eagletrt/hw-fenice-ecu/README.md

# ECU - hardware

ECU hardware design of the E-Agle Trento Racing Team car which run on Fenice.

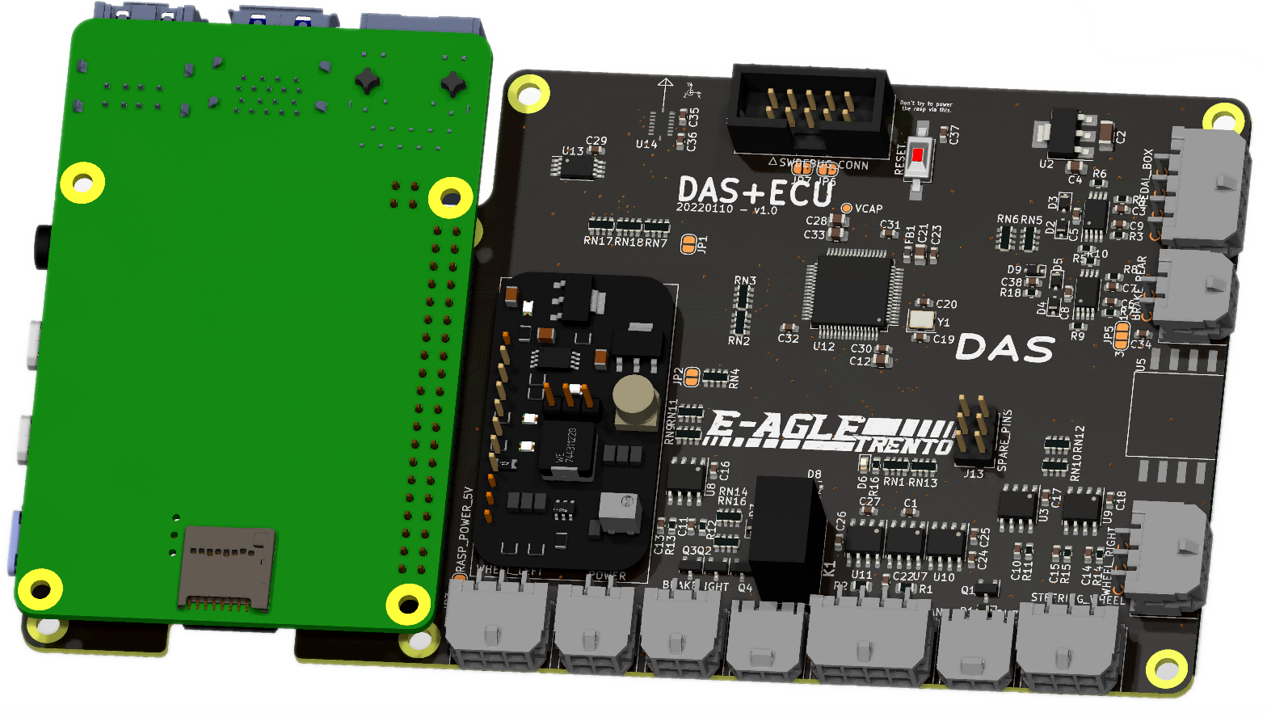
[picture p1: docs/images/board_render.png]


## Contributors

- Filippo Volpe

## Documentation

Documentation can be found under [`./docs/DAS_ECU.md`](./docs/DAS_ECU.md)
