eagletrt/hw-fenice-ecu/docs/board_outline.dxf

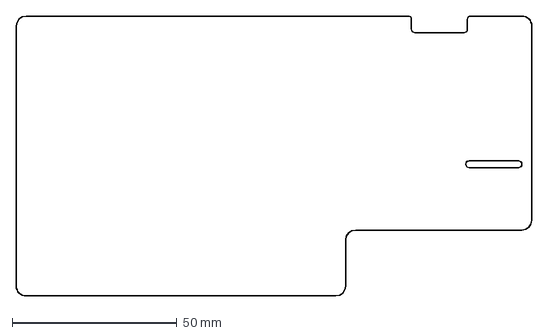
[picture p8: CAD file, 2022-01-07]
docs/board_outline.dxf
156.5 x 85.0 mm
