eagletrt/hw-fenice-ecu/docs/DAS_ECU.pdf

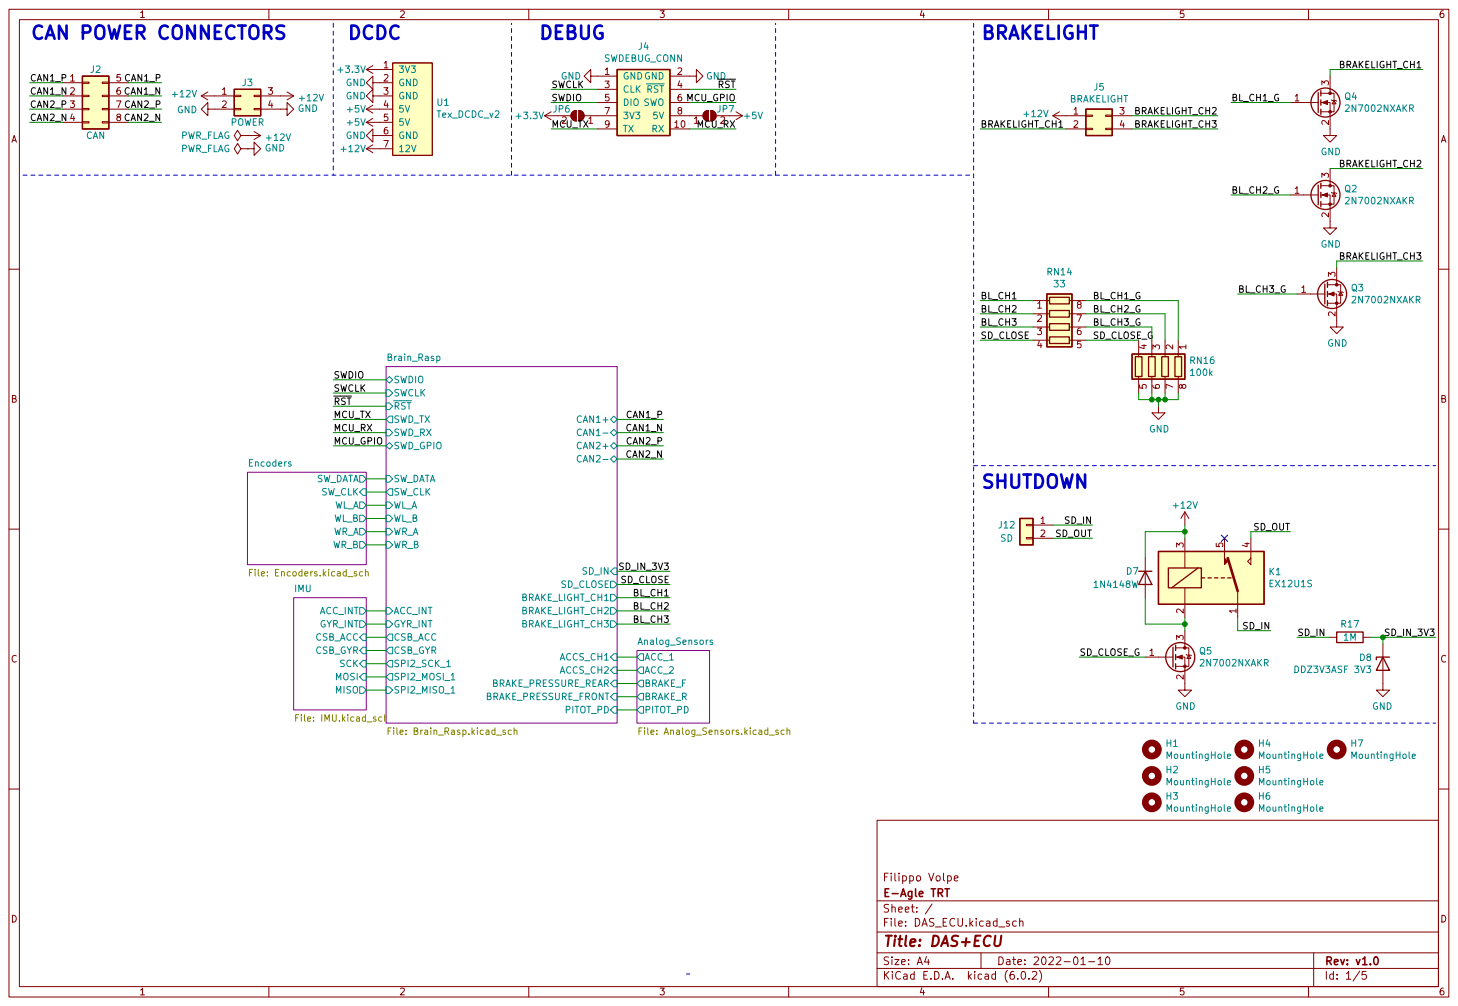
[picture p9: page 1]

CSB_GYR
File: Analog_Sensors.kicad_sch SCK MOSI MISO

File: DAS_ECU.kicad_sch Sheet: / E-Agle TRT

Id: 1/5 Title: DAS+ECU

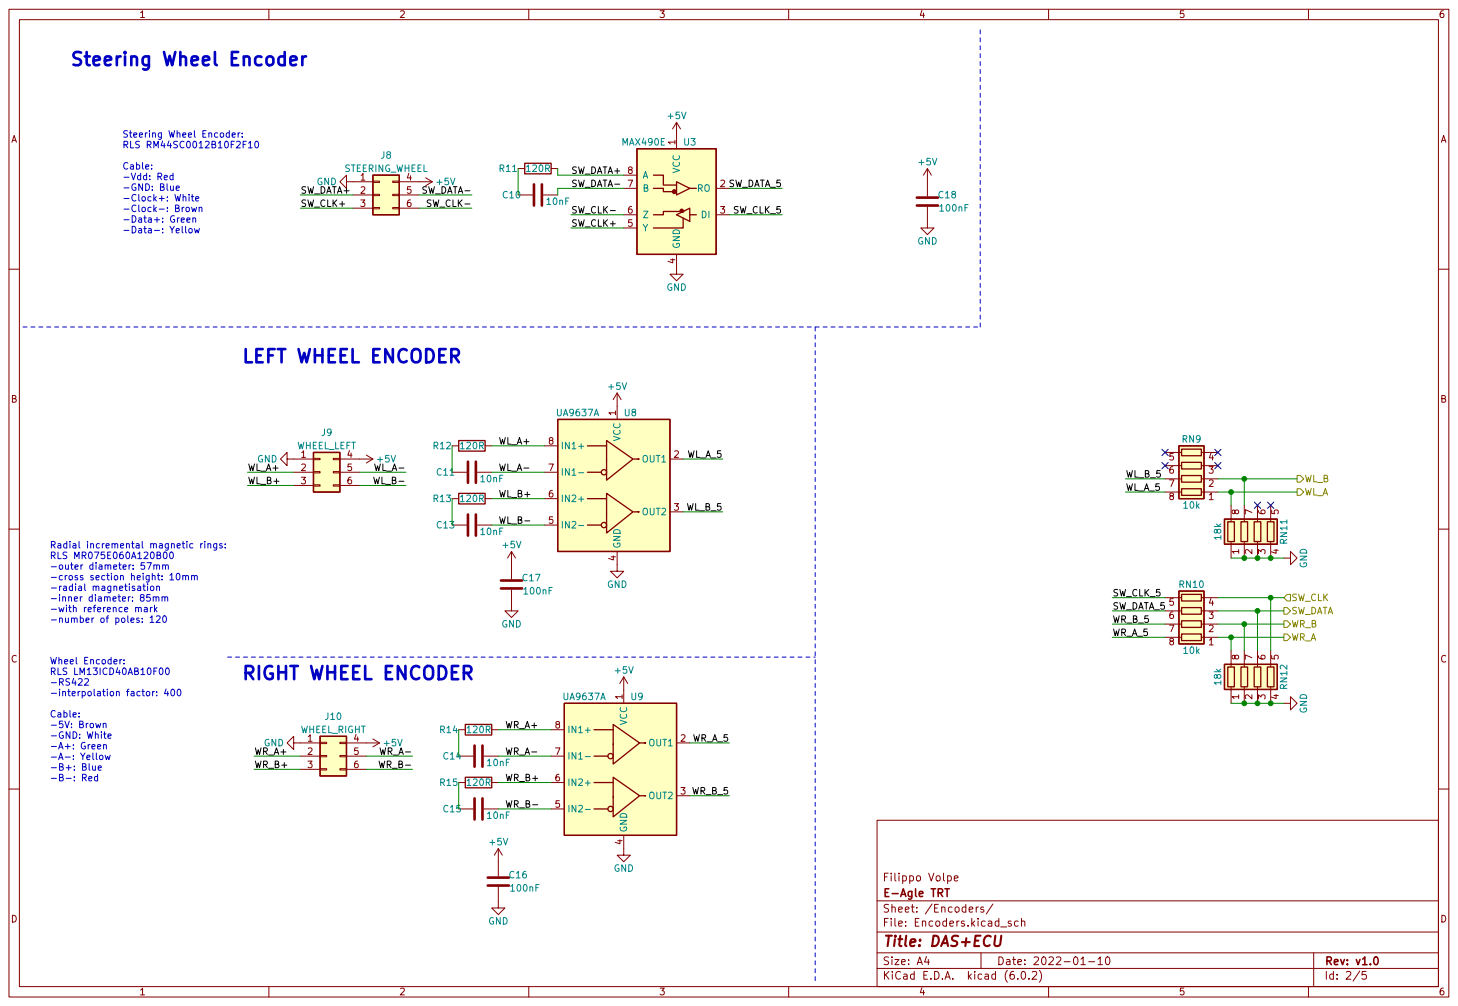
[picture p10: page 2]

Steering Wheel Encoder: RLS RM44SC0012B10F2F10 Cable: -Vdd: Red

Radial incremental magnetic rings: RLS MR075E060A120B00

-interpolation factor: 400 Cable: -5V: Brown

Filippo Volpe
File: Encoders.kicad_sch Sheet: /Encoders/ E-Agle TRT

Id: 2/5 Title: DAS+ECU

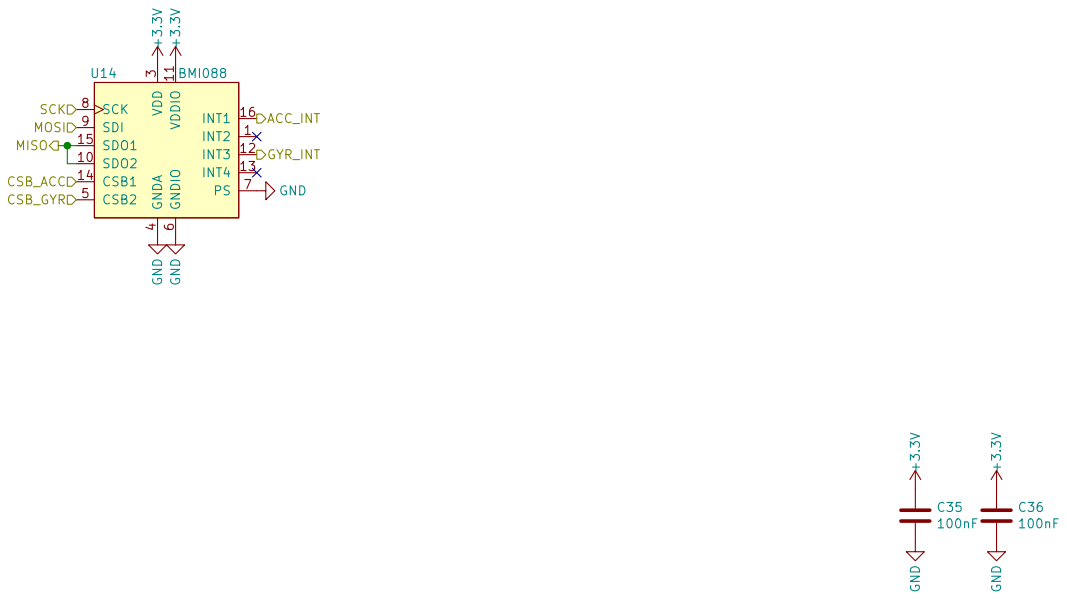
[picture p11: page 3]

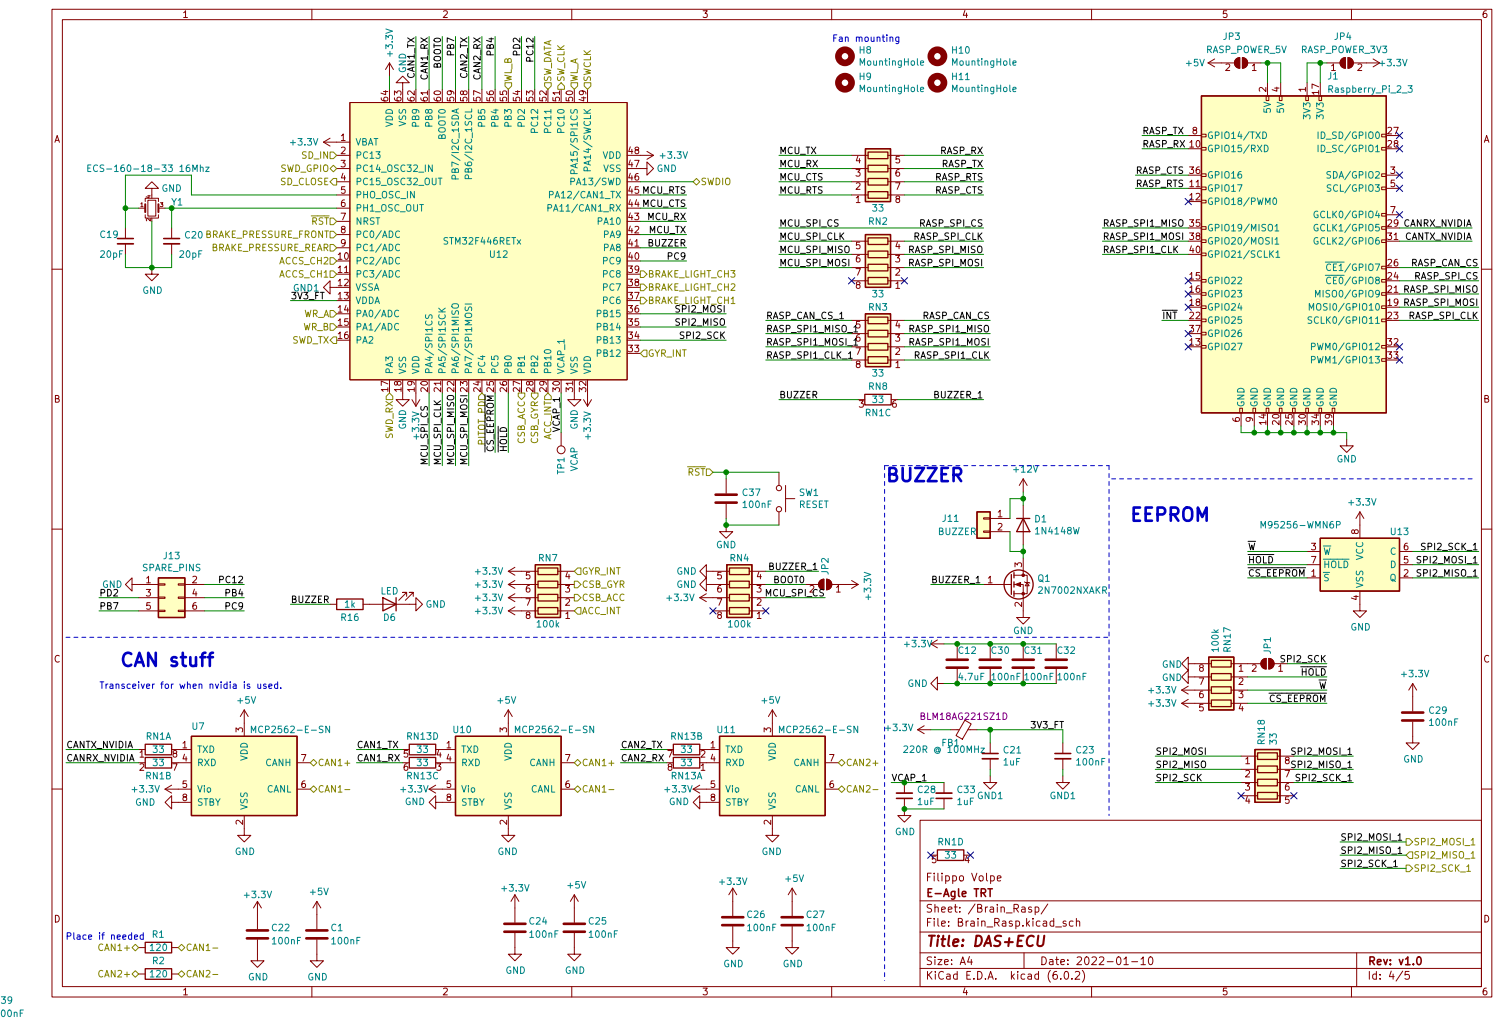
[picture p12: page 4]

3 RXD 4 Vio 5 CANL 6 CANH 7 STBY 8 U10 MCP2562-E-SN GND1

J13 SPARE_PINS GND
Place if needed CAN stuff

Transceiver for when nvidia is used.

3 RXD 4 Vio 5 CANL 6 CANH 7 STBY 8 U7 MCP2562-E-SN GND

3 RXD 4 Vio 5 CANL 6 CANH 7 STBY 8 U11 MCP2562-E-SN

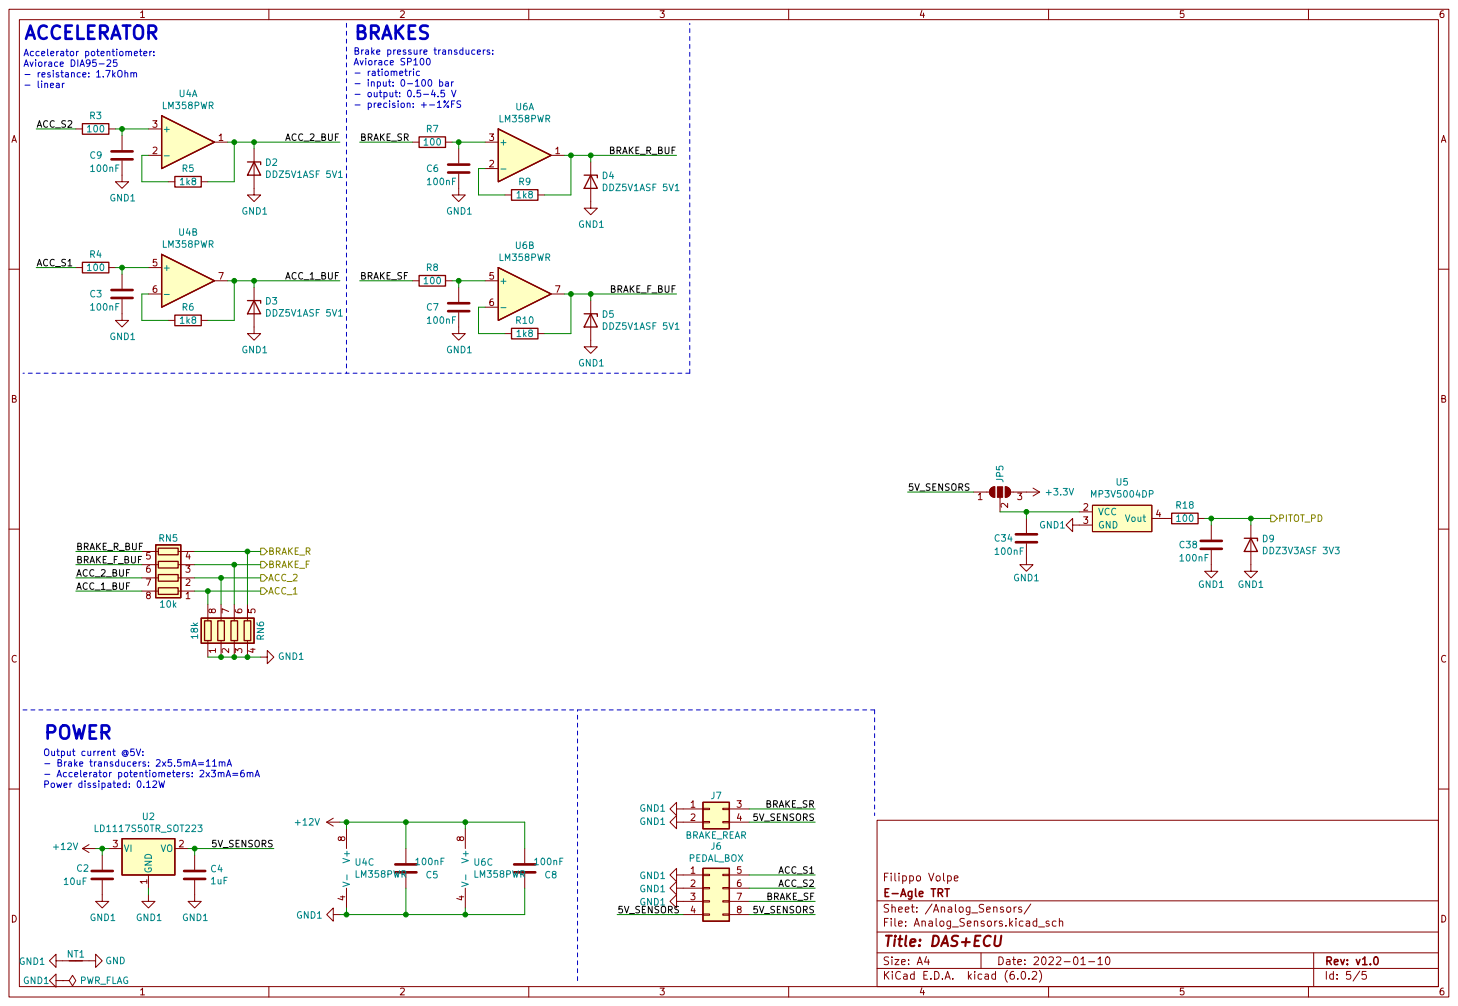
[picture p13: page 5]

Filippo Volpe
E-Agle TRT
Sheet: /Analog_Sensors/
File: Analog_Sensors.kicad_sch
Id: 5/5 Title: DAS+ECU
