eagletrt/hw-fenice-ecu/DAS_ECU.kicad_pcb

## KiCad design DAS_ECU.kicad_pcb (2022-03-17)

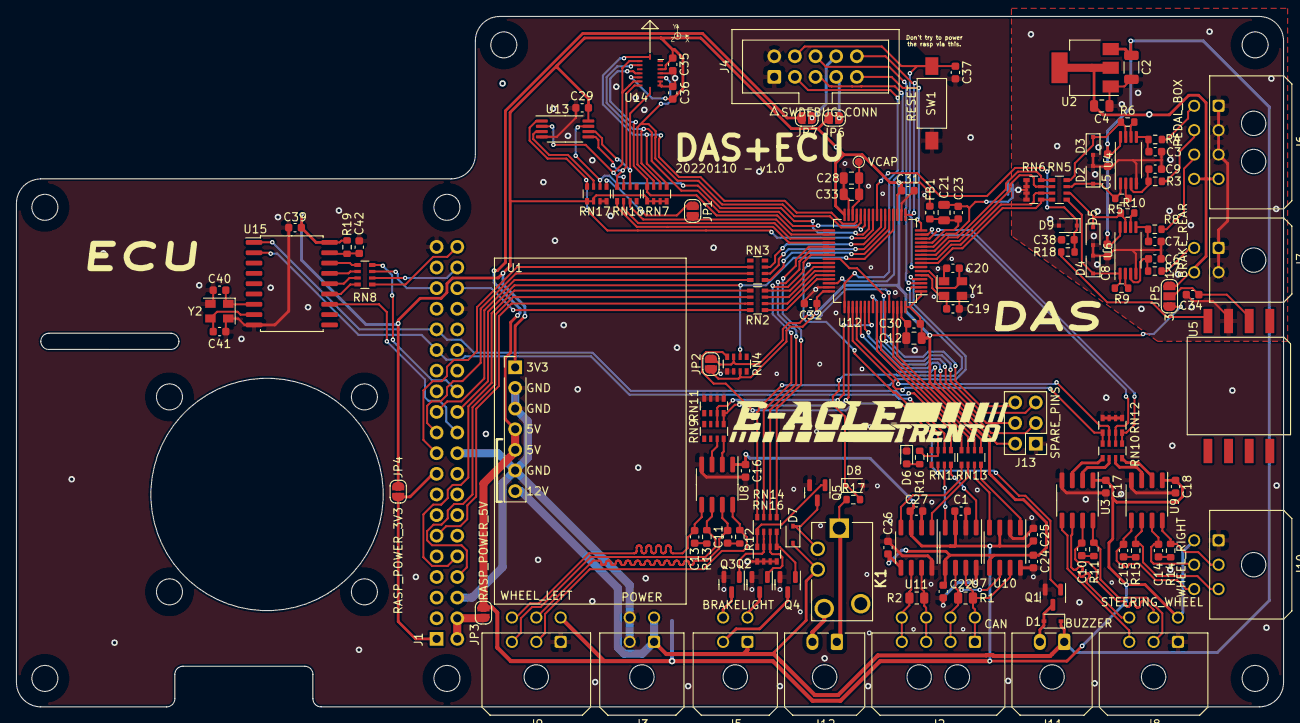
[picture p14: board DAS_ECU.kicad_pcb from above]

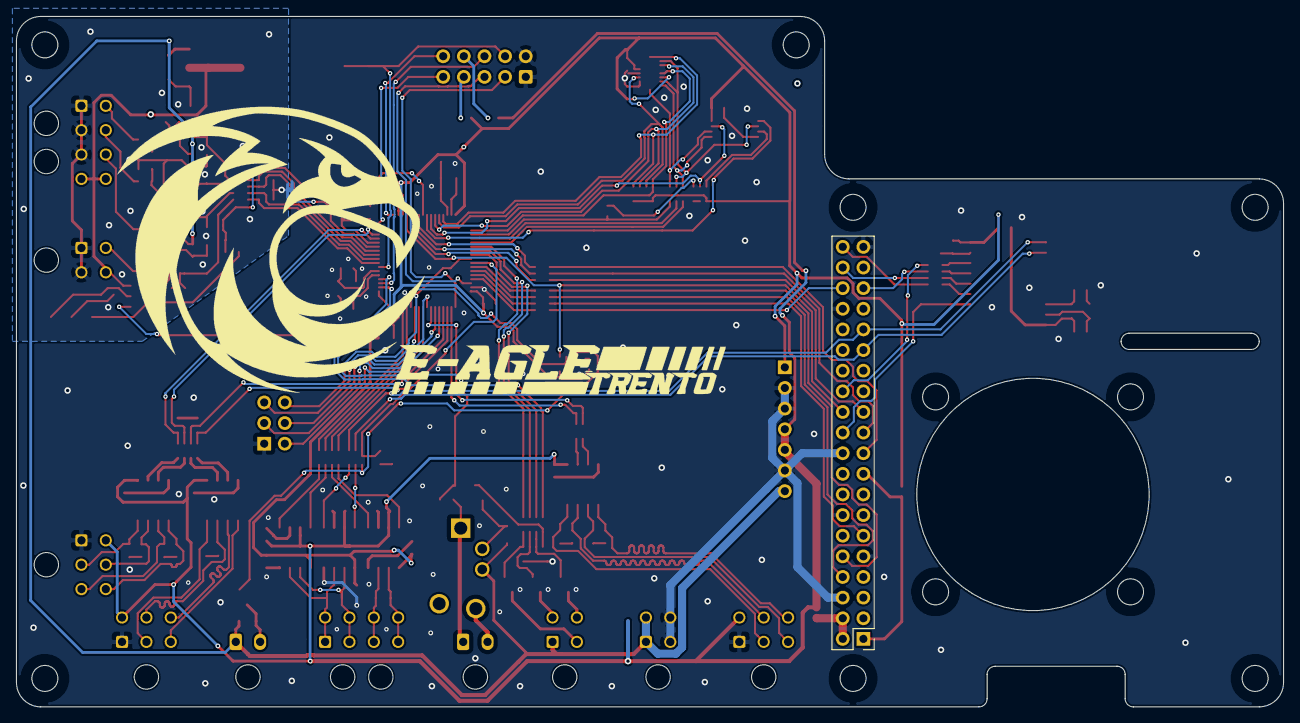
[picture p15: board DAS_ECU.kicad_pcb from below]

Board: 2 copper layers, 156.0 x 85.0 mm, 145 parts (2 on the bottom side), 154 nets.

Parts:
C1, C3, C5, C6, C7, C8, C9, C16, C17, C18, C22, C23, C24, C25, C26, C27, C29, C30, C31, C32, C34, C35, C36, C37, C38, C39, C42: 100nF; C_0603_1608Metric
C2: 10uF; C_1206_3216Metric
C4, C21, C28, C33: 1uF; C_0805_2012Metric
C10, C11, C13, C14, C15: 10nF; C_0603_1608Metric
C12: 4.7uF; C_0805_2012Metric
C19, C20, C40, C41: 20pF; C_0603_1608Metric
D1, D7: 1N4148W; D_SOD-323
D2, D3, D4, D5: DDZ5V1ASF 5V1; D_SOD-323F
D6: LED; LED_0603_1608Metric
D8, D9: DDZ3V3ASF 3V3; D_SOD-323F
FB1: 220R @ 100MHz; L_0603_1608Metric
H1, H2, H3, H4, H5, H6, H7, H8, H9, H10, H11: MountingHole; MountingHole_3.2mm_M3_ISO14580
J1: Raspberry_Pi_2_3; raspberrypi_hat_template
J2: CAN; Molex_Micro-Fit_3.0_43045-0800_2x04_P3.00mm_Horizontal
J3: POWER; Molex_Micro-Fit_3.0_43045-0400_2x02_P3.00mm_Horizontal
J4: SWDEBUG_CONN; IDC-Header_2x05_P2.54mm_Vertical
J5: BRAKELIGHT; Molex_Micro-Fit_3.0_43045-0400_2x02_P3.00mm_Horizontal
J6: PEDAL_BOX; Molex_Micro-Fit_3.0_43045-0800_2x04_P3.00mm_Horizontal
J7: BRAKE_REAR; Molex_Micro-Fit_3.0_43045-0400_2x02_P3.00mm_Horizontal
J8: STEERING_WHEEL; Molex_Micro-Fit_3.0_43045-0600_2x03_P3.00mm_Horizontal
J9: WHEEL_LEFT; Molex_Micro-Fit_3.0_43045-0600_2x03_P3.00mm_Horizontal
J10: WHEEL_RIGHT; Molex_Micro-Fit_3.0_43045-0600_2x03_P3.00mm_Horizontal
J11: BUZZER; Molex_Micro-Fit_3.0_43650-0200_1x02_P3.00mm_Horizontal
J12: SD; Molex_Micro-Fit_3.0_43650-0200_1x02_P3.00mm_Horizontal
J13: SPARE_PINS; PinHeader_2x03_P2.54mm_Vertical
JP1, JP2, JP6, JP7: SolderJumper_2_Open; SolderJumper-2_P1.3mm_Open_RoundedPad1.0x1.5mm
JP3: RASP_POWER_5V; SolderJumper-2_P1.3mm_Open_RoundedPad1.0x1.5mm
JP4: RASP_POWER_3V3; SolderJumper-2_P1.3mm_Open_RoundedPad1.0x1.5mm
JP5: SolderJumper_3; SolderJumper-3_P1.3mm_Open_RoundedPad1.0x1.5mm_NumberLabels
K1: EX12U1S
NT1: Net-Tie_2; connecting_trace_0.6mm
Q1, Q2, Q3, Q4, Q5: 2N7002NXAKR; SOT-23
R1, R2: 120; R_0805_2012Metric
R3, R4, R7, R8, R18: 100; R_0603_1608Metric
R5, R6, R9, R10: 1k8; R_0603_1608Metric
R11, R12, R13, R14, R15: 120R; R_0603_1608Metric
R16: 1k; R_0603_1608Metric
R17: 1M; R_0603_1608Metric
R19: 100k; R_0603_1608Metric
RN1, RN2, RN3, RN8, RN13, RN14, RN18: 33; R_Array_Convex_4x0603
RN4, RN7, RN16, RN17: 100k; R_Array_Convex_4x0603
RN5, RN9, RN10: 10k; R_Array_Convex_4x0603
RN6, RN11, RN12: 18k; R_Array_Convex_4x0603
SW1: RESET; SW_SPST_FSMSM
TP1: VCAP; TestPoint_Pad_D1.0mm
U1: Tex_DCDC_v2; Tex_DCDC_v2_horizontal
U2: LD1117S50TR_SOT223; SOT-223-3_TabPin2
U3: MAX490E; SOIC-8_3.9x4.9mm_P1.27mm
U4, U6: LM358PWR; TSSOP-8_4.4x3mm_P0.65mm
U5: MP3V5004DP; NXP_CASE_1351-01
U7, U10, U11: MCP2562-E-SN; SOIC-8_3.9x4.9mm_P1.27mm
U8, U9: UA9637A; SOIC-8_3.9x4.9mm_P1.27mm
U12: STM32F446RETx; LQFP-64_10x10mm_P0.5mm
U13: M95256-WMN6P; TSSOP-8_4.4x3mm_P0.65mm
U14: BMI088; Bosch_LGA-16_3x4.5mm_P0.5mm
U15: MCP2515-xSO; SOIC-18W_7.5x11.6mm_P1.27mm
Y1, Y2: ECS-160-18-33 16Mhz; Crystal_SMD_EuroQuartz_MT-4Pin_3.2x2.5mm

Connections:
+3V3: C12.1, C22.1, C24.1, C26.1, C29.1, C30.1, C31.1, C32.1, C35.1, C36.1, C39.1, FB1.1, JP2.1, JP4.2, JP5.3, JP6.2, R19.1, RN4.7, RN7.5, RN7.6, RN7.7, RN7.8, RN17.5, RN17.6, U1.1, U7.5, U10.5, U11.5, U12.1, U12.19, U12.32, U12.48, U12.64, U13.8, U14.3, U14.11, U15.18
+5V: C1.1, C16.1, C17.1, C18.1, C25.1, C27.1, J8.4, J9.4, J10.4, JP3.2, JP7.2, U1.4, U1.5, U3.1, U7.3, U8.1, U9.1, U10.3, U11.3
+12V: C2.1, C5.2, C8.2, D1.1, D7.1, J3.1, J3.3, J5.1, J11.1, K1.3, U1.7, U2.3, U4.8, U6.8
/Analog_Sensors/5V_SENSORS: C4.1, J6.4, J6.8, J7.4, JP5.1, U2.2
/Analog_Sensors/ACC_1_BUF: D3.1, R6.1, RN5.8, U4.7
/Analog_Sensors/ACC_2_BUF: D2.1, R5.1, RN5.7, U4.1
/Analog_Sensors/ACC_S1: J6.5, R4.2
/Analog_Sensors/ACC_S2: J6.6, R3.2
/Analog_Sensors/BRAKE_F: RN5.3, RN6.6, U12.9
/Analog_Sensors/BRAKE_F_BUF: D5.1, R10.1, RN5.6, U6.7
/Analog_Sensors/BRAKE_R_BUF: D4.1, R9.1, RN5.5, U6.1
/Analog_Sensors/BRAKE_SF: J6.7, R8.2
/Analog_Sensors/BRAKE_SR: J7.3, R7.2
/Analog_Sensors/PITOT_PD: C38.1, D9.1, R18.1, U12.24
/BL_CH1: RN14.1, U12.37
/BL_CH1_G: Q4.1, RN14.8, RN16.1
/BL_CH2: RN14.2, U12.38
/BL_CH2_G: Q2.1, RN14.7, RN16.2
/BL_CH3: RN14.3, U12.39
/BL_CH3_G: Q3.1, RN14.6, RN16.3
/BRAKELIGHT_CH1: J5.2, Q4.3
/BRAKELIGHT_CH2: J5.3, Q2.3
/BRAKELIGHT_CH3: J5.4, Q3.3
/Brain_Rasp/3V3_FT: C21.1, C23.1, FB1.2, U12.13
/Brain_Rasp/ACCS_CH1: RN5.1, RN6.8, U12.11
/Brain_Rasp/ACCS_CH2: RN5.2, RN6.7, U12.10
/Brain_Rasp/ACC_INT: RN7.1, U12.29, U14.16
/Brain_Rasp/BOOT0: JP2.2, RN4.3, U12.60
/Brain_Rasp/BRAKE_PRESSURE_FRONT: RN5.4, RN6.5, U12.8
/Brain_Rasp/BUZZER: R16.1, RN1.3, U12.41
/Brain_Rasp/BUZZER_1: Q1.1, RN1.6, RN4.4
/Brain_Rasp/CAN1_RX: RN13.6, U12.61
/Brain_Rasp/CAN1_TX: RN13.5, U12.62
/Brain_Rasp/CAN2_RX: RN13.8, U12.57
/Brain_Rasp/CAN2_TX: RN13.7, U12.58
/Brain_Rasp/CANRX_NVIDIA: J1.29, RN1.2, U15.2
/Brain_Rasp/CANTX_NVIDIA: J1.31, RN1.1, U15.1
/Brain_Rasp/CSB_ACC: RN7.2, U12.27, U14.14
/Brain_Rasp/CSB_GYR: RN7.3, U12.28, U14.5
/Brain_Rasp/GYR_INT: RN7.4, U12.33, U14.12
/Brain_Rasp/MCU_CTS: RN2.2, U12.44
/Brain_Rasp/MCU_RTS: RN2.1, U12.45
/Brain_Rasp/MCU_RX: RN2.3, U12.43
/Brain_Rasp/MCU_SPI_CLK: RN3.5, U12.21
/Brain_Rasp/MCU_SPI_CS: J1.24, RN4.2, U12.20
/Brain_Rasp/MCU_SPI_MISO: RN3.6, U12.22
/Brain_Rasp/MCU_SPI_MOSI: RN3.7, U12.23
/Brain_Rasp/MCU_TX: RN2.4, U12.42
/Brain_Rasp/PB4: J13.4, U12.56
/Brain_Rasp/PB7: J13.5, U12.59
/Brain_Rasp/PC9: J13.6, U12.40
/Brain_Rasp/PC12: J13.2, U12.53
/Brain_Rasp/PD2: J13.3, U12.54
/Brain_Rasp/RASP_CAN_CS: J1.26, RN8.4
/Brain_Rasp/RASP_CAN_CS_1: RN8.5, U15.16
/Brain_Rasp/RASP_CTS: J1.36, RN2.8
/Brain_Rasp/RASP_RTS: J1.11, RN2.7
/Brain_Rasp/RASP_RX: J1.10, RN2.5
/Brain_Rasp/RASP_SPI1_CLK: J1.40, RN8.1
/Brain_Rasp/RASP_SPI1_CLK_1: RN8.8, U15.13
/Brain_Rasp/RASP_SPI1_MISO: J1.35, RN8.3
/Brain_Rasp/RASP_SPI1_MISO_1: RN8.6, U15.15
/Brain_Rasp/RASP_SPI1_MOSI: J1.38, RN8.2
/Brain_Rasp/RASP_SPI1_MOSI_1: RN8.7, U15.14
/Brain_Rasp/RASP_SPI_CLK: J1.23, RN3.4
/Brain_Rasp/RASP_SPI_MISO: J1.21, RN3.3
/Brain_Rasp/RASP_SPI_MOSI: J1.19, RN3.2
/Brain_Rasp/RASP_TX: J1.8, RN2.6
/Brain_Rasp/SPI2_MISO: RN18.2, U12.35
/Brain_Rasp/SPI2_MOSI: RN18.1, U12.36
/Brain_Rasp/SPI2_SCK: JP1.1, RN18.3, U12.34
/Brain_Rasp/SW_CLK: RN10.4, RN12.5, U12.51
/Brain_Rasp/SW_DATA: RN10.3, RN12.6, U12.52
/Brain_Rasp/VCAP_1: C28.2, C33.2, TP1.1, U12.30
/Brain_Rasp/WL_A: RN9.1, RN11.8, U12.50
/Brain_Rasp/WL_B: RN9.2, RN11.7, U12.55
/Brain_Rasp/WR_A: RN10.1, RN12.8, U12.14
/Brain_Rasp/WR_B: RN10.2, RN12.7, U12.15
/Brain_Rasp/~CS_EEPROM: RN17.4, U12.25, U13.1
/Brain_Rasp/~HOLD: RN17.2, U12.26, U13.7
/Brain_Rasp/~INT: J1.22, U15.12
/Brain_Rasp/~W: RN17.3, U13.3
/CAN1_N: J2.2, J2.6, R1.2, U7.6, U10.6
/CAN1_P: J2.1, J2.5, R1.1, U7.7, U10.7
/CAN2_N: J2.4, J2.8, R2.2, U11.6
/CAN2_P: J2.3, J2.7, R2.1, U11.7
/Encoders/SW_CLK+: J8.3, U3.5
/Encoders/SW_CLK-: J8.6, U3.6
/Encoders/SW_CLK_5: RN10.5, U3.3
/Encoders/SW_DATA+: J8.2, R11.2, U3.8
/Encoders/SW_DATA-: C10.1, J8.5, U3.7
/Encoders/SW_DATA_5: RN10.6, U3.2
/Encoders/WL_A+: J9.2, R12.2, U8.8
/Encoders/WL_A-: C11.1, J9.5, U8.7
/Encoders/WL_A_5: RN9.8, U8.2
/Encoders/WL_B+: J9.3, R13.2, U8.6
/Encoders/WL_B-: C13.1, J9.6, U8.5
/Encoders/WL_B_5: RN9.7, U8.3
/Encoders/WR_A+: J10.2, R14.2, U9.8
/Encoders/WR_A-: C14.1, J10.5, U9.7
/Encoders/WR_A_5: RN10.8, U9.2
/Encoders/WR_B+: J10.3, R15.2, U9.6
/Encoders/WR_B-: C15.1, J10.6, U9.5
/Encoders/WR_B_5: RN10.7, U9.3
/IMU/MISO: RN18.7, U13.2, U14.10, U14.15
/IMU/MOSI: RN18.8, U13.5, U14.9
/IMU/SCK: RN18.6, U13.6, U14.8
/MCU_GPIO: J4.6, U12.3
/MCU_RX: J4.10, U12.17
/MCU_TX: J4.9, U12.16
/SD_CLOSE: RN14.4, U12.4
/SD_CLOSE_G: Q5.1, RN14.5, RN16.4
/SD_IN: J12.1, K1.1, R17.1
/SD_IN_3V3: D8.1, R17.2, U12.2
/SD_OUT: J12.2, K1.4
/SWCLK: J4.3, U12.49
/SWDIO: J4.5, U12.46
/~RST: C37.1, J4.4, SW1.1, U12.7
GND: C1.2, C12.2, C16.2, C17.2, C18.2, C19.2, C20.2, C22.2, C24.2, C25.2, C26.2, C27.2, C28.1, C29.2, C30.2, C31.2, C32.2, C33.1, C35.2, C36.2, C37.2, C39.2, C40.2, C41.2, C42.1, D6.1, D8.2, J1.6, J1.9, J1.14, J1.20, J1.25, J1.30, J1.34, J1.39, J3.2, J3.4, J4.1, J4.2, J8.1, J9.1, J10.1, J13.1, NT1.2, Q1.2, Q2.2, Q3.2, Q4.2, Q5.2, RN4.5, RN4.6, RN11.1, RN11.2, RN11.3, RN11.4, RN12.1, RN12.2, RN12.3, RN12.4, RN16.5, RN16.6, RN16.7, RN16.8, RN17.7, RN17.8, SW1.2, U1.2, U1.3, U1.6, U3.4, U7.2, U7.8, U8.4, U9.4, U10.2, U10.8, U11.2, U11.8, U12.18, U12.31, U12.47, U12.63, U13.4, U14.4, U14.6, U14.7, U15.9, Y1.2, Y1.4, Y2.2, Y2.4
GND1: C2.2, C3.2, C4.2, C5.1, C6.2, C7.2, C8.1, C9.2, C21.2, C23.2, C34.2, C38.2, D2.2, D3.2, D4.2, D5.2, D9.2, J6.1, J6.2, J6.3, J7.1, J7.2, NT1.1, RN6.1, RN6.2, RN6.3, RN6.4, U2.1, U4.4, U5.3, U6.4, U12.12
unnamed: C3.1, R4.1, U4.5
unnamed: C6.1, R7.1, U6.3
unnamed: C7.1, R8.1, U6.5
unnamed: C9.1, R3.1, U4.3
unnamed: C10.2, R11.1
unnamed: C11.2, R12.1
unnamed: C13.2, R13.1
unnamed: C14.2, R14.1
unnamed: C15.2, R15.1
unnamed: C19.1, U12.5, Y1.1
unnamed: C20.1, U12.6, Y1.3
unnamed: C34.1, JP5.2, U5.2
unnamed: C40.1, U15.7, Y2.1
unnamed: C41.1, U15.8, Y2.3
unnamed: C42.2, R19.2, U15.17
unnamed: D1.2, J11.2, Q1.3
unnamed: D6.2, R16.2
unnamed: D7.2, K1.2, Q5.3
unnamed: J1.1, J1.17, JP4.1
unnamed: J1.2, J1.4, JP3.1
unnamed: J4.7, JP6.1
unnamed: J4.8, JP7.1
unnamed: JP1.2, RN17.1
unnamed: R5.2, U4.2
unnamed: R6.2, U4.6
unnamed: R9.2, U6.2
unnamed: R10.2, U6.6
unnamed: R18.2, U5.4
unnamed: RN1.7, U7.4
unnamed: RN1.8, U7.1
unnamed: RN13.1, U11.4
unnamed: RN13.2, U11.1
unnamed: RN13.3, U10.4
unnamed: RN13.4, U10.1
