eagletrt/hw-fenice-ecu/(commit log)

2021-12-13 in progress push, still laying down preliminary schematic
    [BRAIN.sch, DAS_ECU.kicad_pcb, DAS_ECU.sch, Encoders.sch, Pedals_SET.sch]
2021-12-15 some other progress 2021-12-15
    [Brain_Rasp.sch, DAS_ECU.sch, Encoders.sch, Pedals_SET.sch]
2022-01-05 modification of the schematic
    [Brain_Rasp.sch, DAS_ECU.sch, Encoders.sch, Pedals_SET.sch]
2022-01-05 added all footprints, starting board
    [Brain_Rasp.sch, DAS_ECU.sch, Encoders.sch, Pedals_SET.sch]
2022-01-05 corrected wrong connections
    [Brain_Rasp.sch, DAS_ECU.sch, Encoders.sch]
2022-01-05 started board, some corrections on schematic
    [Brain_Rasp.sch, DAS_ECU.kicad_pcb, DAS_ECU.sch, Encoders.sch, Pedals_SET.sch]
2022-01-06 more progrees on board
    [Brain_Rasp.sch, DAS_ECU.kicad_pcb, DAS_ECU.sch, Encoders.sch, Pedals_SET.sch]
2022-01-07 added board outline drawing
    [board_outline.dxf]
2022-01-08 added IMU, pressure sensor, progress on board
    [Analog_Sensors.sch, Brain_Rasp.sch, DAS_ECU.kicad_pcb, DAS_ECU.sch, Encoders.sch, IMU.sch]
2022-01-10 Board finished electrically, passes ERC/DRC
    [Analog_Sensors.sch, Brain_Rasp.sch, DAS_ECU.kicad_pcb, DAS_ECU.sch]
2022-01-10 Print ready v1.0
    [Analog_Sensors.sch, Brain_Rasp.sch, DAS_ECU.kicad_pcb, DAS_ECU.sch, Encoders.sch, IMU.sch]
2022-01-14 changed to LM358PWR
    [Analog_Sensors.sch, DAS_ECU.kicad_pcb]
2022-01-23 added MCP2515
    [Brain_Rasp.sch, DAS_ECU.kicad_pcb, DAS_ECU.sch]
2022-02-21 updated pdb schematic
2022-03-12 add note for how to connect encoder to board
    [Encoders.sch]
2022-03-17 removed kicad v5 files
    [Analog_Sensors.sch, Brain_Rasp.sch, DAS_ECU.kicad_pcb, DAS_ECU.sch, Encoders.sch, IMU.sch]
2022-03-17 converted to kicad v6
    [Analog_Sensors.kicad_sch, Brain_Rasp.kicad_sch, DAS_ECU.kicad_sch, Encoders.kicad_sch, IMU.kicad_sch]
